craigyjp/Pico-RP2040-Autotune-AS3340/schematics/programmer.pdf

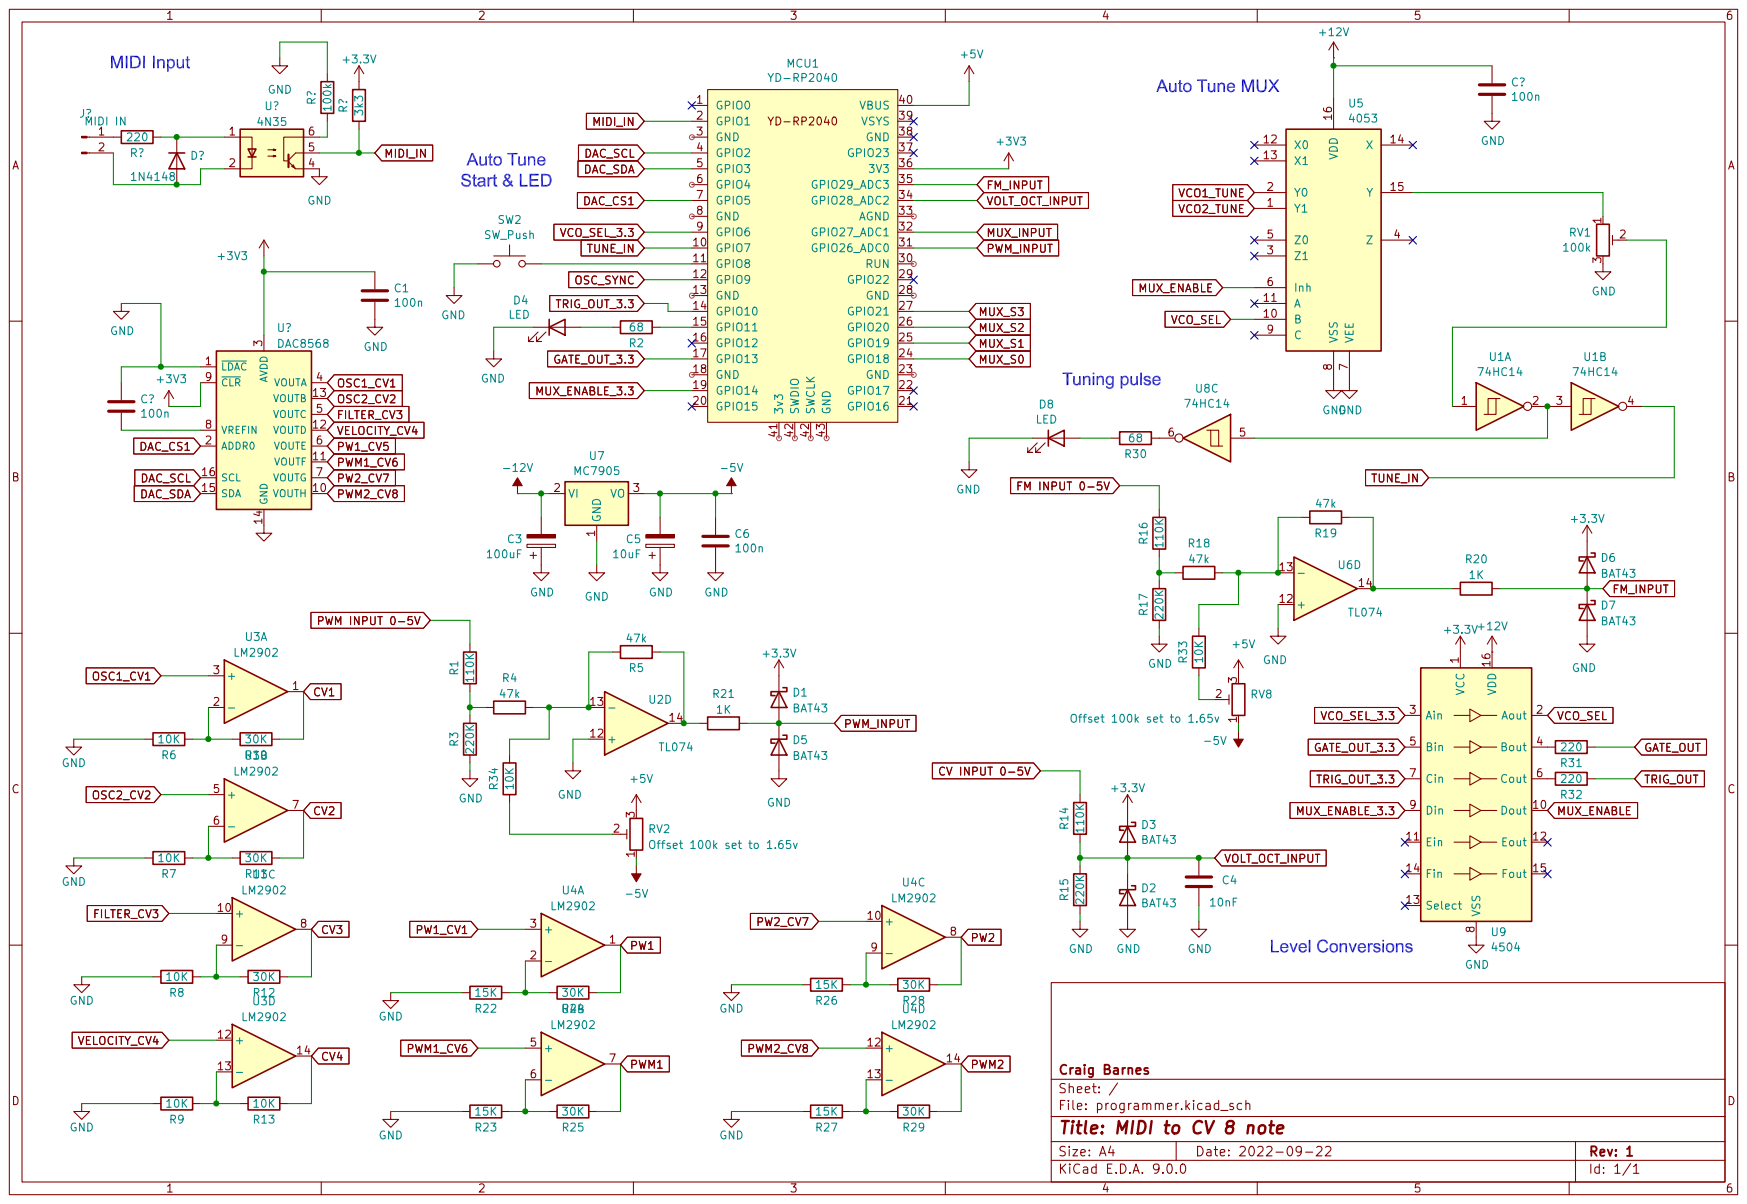
[picture p1: page 1]
