craigyjp/Pico-RP2040-Autotune-AS3340/schematics/mux.pdf

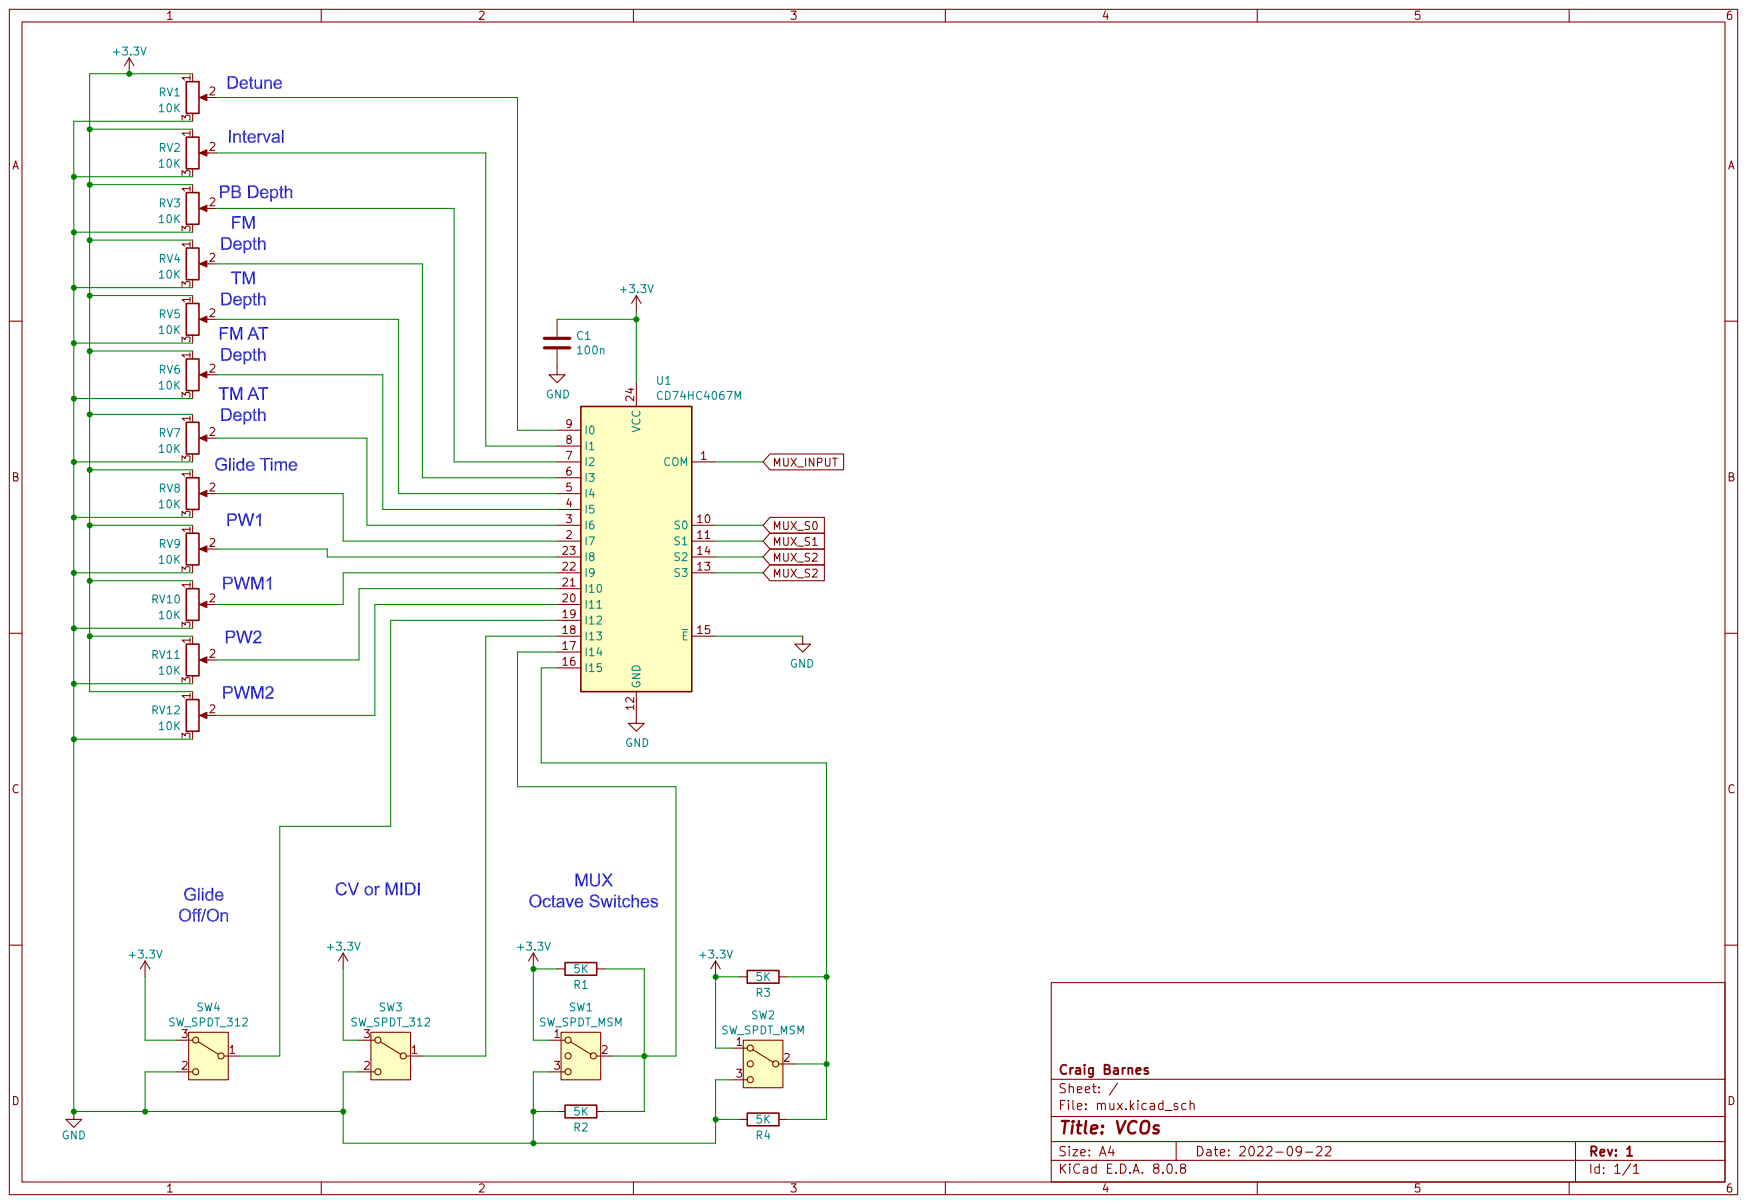
[picture p2: page 1]
