craigyjp/Pico-RP2040-Autotune-AS3340/schematics/Oscillators.pdf

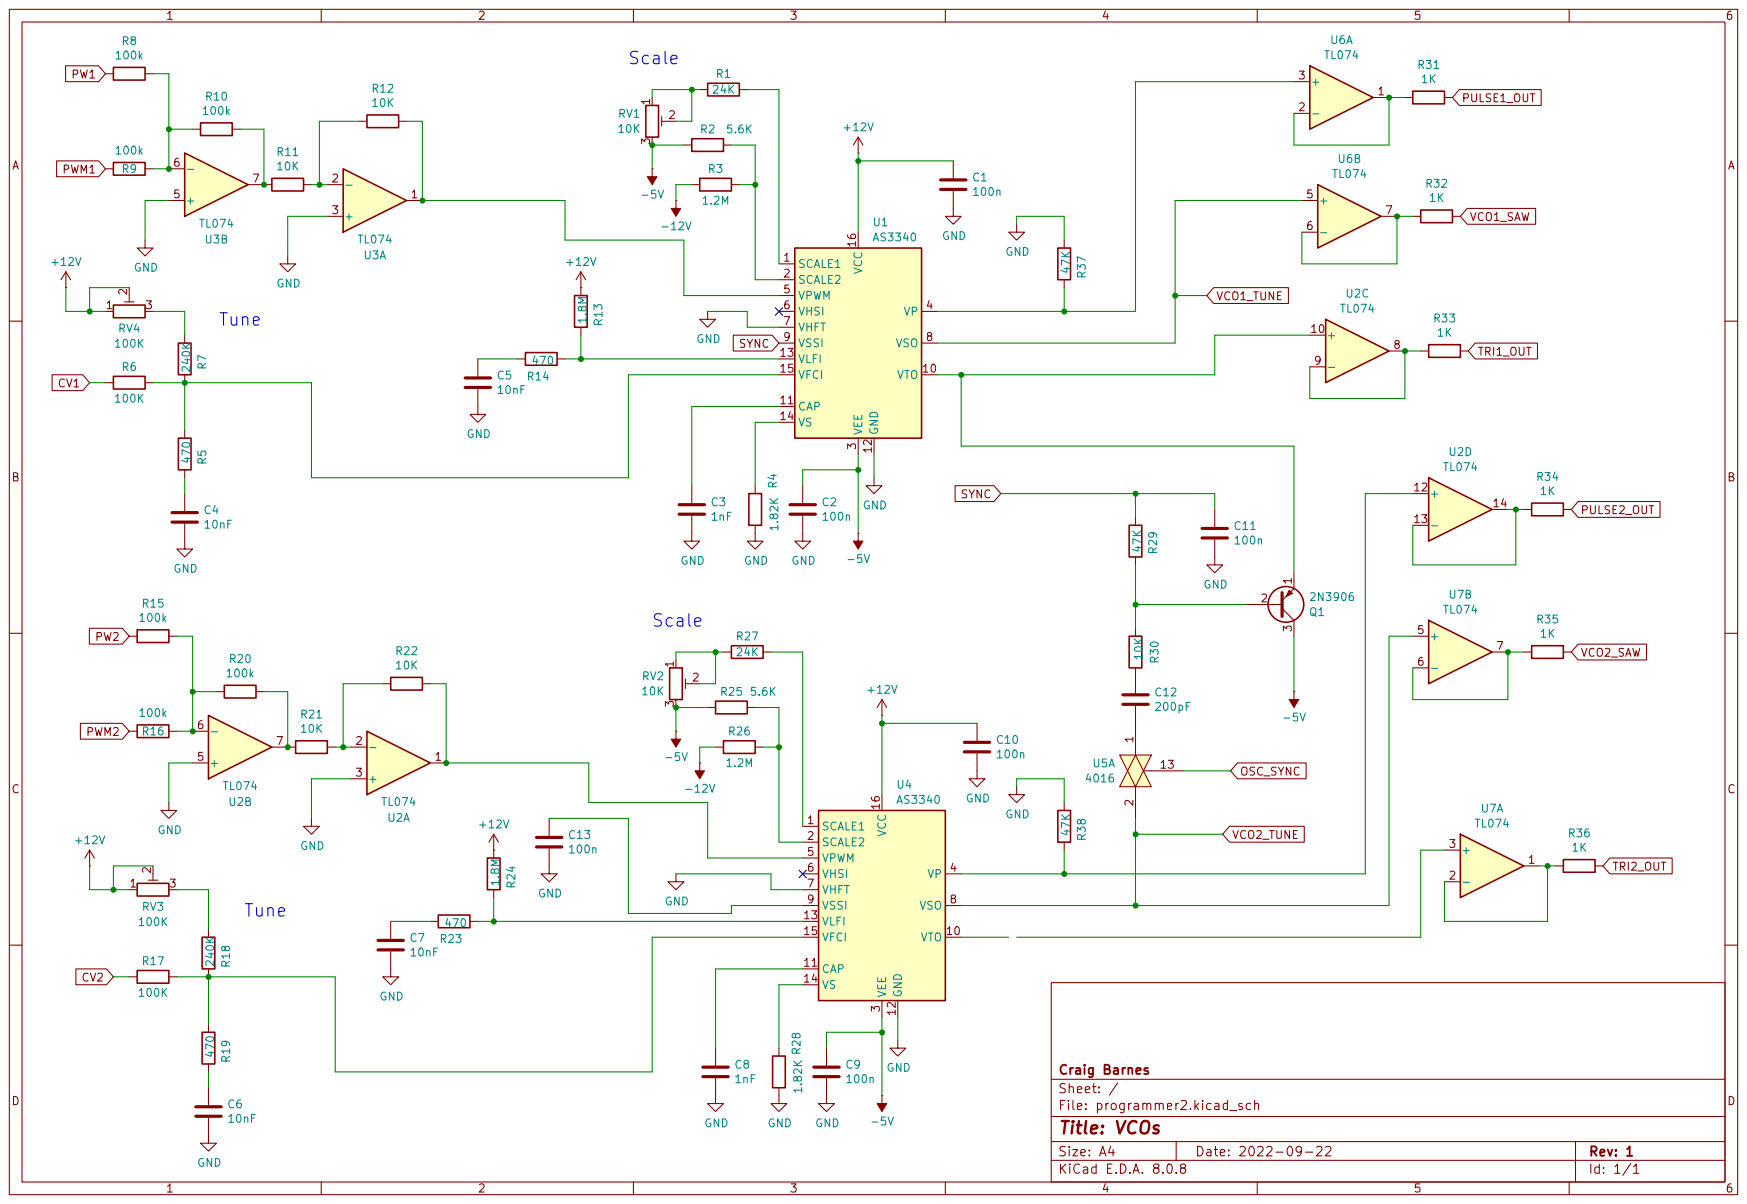
[picture p3: page 1]
