craigyjp/Pico-RP2040-Autotune-AS3340/16bit_1_note_Pico_MIDI_CV_poly_autotune.ino

/*
       MIDI to CV with Autotune

       For RP2040

       Filesystem 1.5Mb/0.5Mb

      Version 1.1

      Copyright (C) 2020 Craig Barnes

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
      This program is distributed in the hope that it will be useful,
      but WITHOUT ANY WARRANTY; without even the implied warranty of
      MERCHANTABILITY or FITNESS FOR A PARTICULAR PURPOSE.  See the
      GNU General Public License <http://www.gnu.org/licenses/> for more details.
*/
#include <Arduino.h>
#include <iostream>
#include <cfloat>  // Include for DBL_MAX
#include <SPI.h>
#include <MIDI.h>
#include "Parameters.h"
#include "Hardware.h"
#include <Adafruit_NeoPixel.h>
#include <FS.h>
#include <LittleFS.h>

struct VoiceAndNote {
  int note;
  int velocity;
  long timeOn;
  bool sustained;  // Sustain flag
  bool keyDown;
  double noteFreq;  // Note frequency
  int position;
  bool noteOn;
};

// Struct to store note data with derivatives
struct NoteData {
  int value;
  double derivative;
};

struct VoiceAndNote voices[NO_OF_VOICES] = {
  { -1, -1, 0, false, false, 0, -1, false },
};

boolean voiceOn[NO_OF_VOICES] = { false };
bool notes[128] = { 0 }, initial_loop = 1;
int8_t noteOrder[40] = { 0 }, orderIndx = { 0 };
bool S1, S2;

// MIDI setup

MIDI_CREATE_INSTANCE(HardwareSerial, Serial1, MIDI);
const int channel = 1;

#define LED_PIN 23    // Define the pin for the built-in RGB LED
#define NUM_PIXELS 1  // Number of WS2812 LEDs

Adafruit_NeoPixel pixels(NUM_PIXELS, LED_PIN, NEO_GRB + NEO_KHZ800);

void setup() {
  Serial.begin(115200);

  // while (!Serial)
  //   ;  // Wait for Serial to connect

  if (!LittleFS.begin()) {
    Serial.println("Failed to mount LittleFS");
    return;
  }

  Serial.println("LittleFS mounted successfully");

  pinMode(AUTO_INPUT, INPUT_PULLUP);

  SPI.setSCK(2);
  SPI.setRX(4);
  SPI.setTX(3);
  SPI.begin();

  delay(10);

  setupHardware();

  //MIDI 5 Pin DIN
  MIDI.begin(masterChan);
  MIDI.setHandleNoteOn(myNoteOn);
  MIDI.setHandleNoteOff(myNoteOff);
  MIDI.setHandlePitchBend(myPitchBend);
  MIDI.setHandleControlChange(myControlChange);
  MIDI.setHandleAfterTouchChannel(myAfterTouch);
  Serial.println("MIDI In DIN Listening");

  pixels.begin();
  delay(500);
  pixels.setPixelColor(0, pixels.Color(0, 255, 0));  // GREEN
  pixels.show();

  loadTuningCorrectionsFromSD();
}

void muxRead() {
  mux1Read = analogRead(MUX_INPUT);

  if (mux1Read > (mux1ValuesPrev[muxInput] + QUANTISE_FACTOR) || mux1Read < (mux1ValuesPrev[muxInput] - QUANTISE_FACTOR)) {
    mux1ValuesPrev[muxInput] = mux1Read;
    switch (muxInput) {

      case MUX1_DETUNE:  // 0
        value = mux1Read;
        DETUNE = map(value, 0, 4095, 0, 127);
        break;

      case MUX1_INTERVAL:  // 1
        value = mux1Read;
        INTERVAL_POT = map(value, 0, 4095, 0, 12);
        break;

      case MUX1_PB_DEPTH:  // 2
        value = mux1Read;
        BEND_WHEEL = map(value, 0, 4095, 0, 12);
        break;

      case MUX1_FM_MOD_DEPTH:  // Modwheel depth to FM 3
        value = mux1Read;
        FM_MOD_WHEEL = map(value, 0, 4095, 0, 16.12);
        break;

      case MUX1_TM_MOD_DEPTH:  // Modwheel Depth to TM 4
        value = mux1Read;
        TM_MOD_WHEEL = map(value, 0, 4095, 0, 16.12);
        break;

      case MUX1_FM_AT_DEPTH:  // AT depth to FM 5
        value = mux1Read;
        FM_AT_WHEEL = map(value, 0, 4095, 0, 16.12);
        break;

      case MUX1_TM_AT_DEPTH:  // AT depth to TM 6
        value = mux1Read;
        TM_AT_WHEEL = map(value, 0, 4095, 0, 16.12);
        break;

      case MUX1_GLIDE_TIME:  // 7
        GLIDE_TIME = mux1Read;
        portamentoTime = map(GLIDE_TIME, 0, 4095, 0, 10000);
        break;

      case MUX1_PW1:  // 8
        value = mux1Read;
        PW1 = map(value, 0, 4095, 0, 17000);
        break;

      case MUX1_PWM1_DEPTH:  // 9
        value = mux1Read;
        PWM1 = map(value, 0, 4095, 0, 20000);
        break;

      case MUX1_PW2:  // 10
        value = mux1Read;
        PW2 = map(value, 0, 4095, 0, 17000);
        break;

      case MUX1_PWM2_DEPTH:  // 11
        value = mux1Read;
        PWM2 = map(value, 0, 4095, 0, 20000);
        break;

      case MUX1_GLIDE_ON_OFF:  // 12
        value = mux1Read;
        portamentoOn = map(value, 0, 4095, 0, 1);
        break;

      case MUX1_CV_MIDI:  // 13
        value = mux1Read;
        value = map(value, 0, 127, 0, 1);
        switch (value) {
          case 0:
            cvMidi = false;
            break;
          case 1:
            cvMidi = true;
            break;
        }
        break;

      case MUX1_OCTAVE_A:  // 14
        value = mux1Read;
        value = map(value, 0, 127, 0, 2);
        switch (value) {
          case 0:
            OCTAVE_A = -12;
            break;
          case 1:
            OCTAVE_A = 0;
            break;
          case 2:
            OCTAVE_A = 12;
            break;
        }
        break;

      case MUX1_OCTAVE_B:  // 15
        value = mux1Read;
        value = map(value, 0, 127, 0, 2);
        switch (value) {
          case 0:
            OCTAVE_B = -12;
            break;
          case 1:
            OCTAVE_B = 0;
            break;
          case 2:
            OCTAVE_B = 12;
            break;
        }
        break;
    }
  }

  muxInput++;
  if (muxInput >= MUXCHANNELS)
    muxInput = 0;

  digitalWrite(MUX_S0, muxInput & 0b0001);
  digitalWrite(MUX_S1, muxInput & 0b0010);
  digitalWrite(MUX_S2, muxInput & 0b0100);
  digitalWrite(MUX_S3, muxInput & 0b1000);
}

void readNoteCV() {
  if (cvMidi) {
    // Step 1: Read ADC and apply calibration
    adcBuffer[bufferIndex] = analogRead(VOLT_OCT_INPUT) * AD_CH1_calb;
    bufferIndex = (bufferIndex + 1) % NUM_SAMPLES;

    // Compute moving average
    int adcSum = 0;
    for (int i = 0; i < NUM_SAMPLES; i++) {
      adcSum += adcBuffer[i];
    }
    int adcValue = (adcSum / NUM_SAMPLES) - ADC_OFFSET;  // Offset correction

    // Prevent negative values
    if (adcValue < 0) {
      adcValue = 0;
    }

    // Step 3: Ignore small changes
    if (abs(old_ADC - adcValue) > HYSTERESIS_THRESHOLD) {

      // Step 4: Quantize input
      for (int i = 0; i <= 60; i++) {

        if (adcValue >= cv_qnt_thr_buf1[i] && adcValue < cv_qnt_thr_buf1[i + 1]) {
          search_qnt = i;
          cmp1 = adcValue - cv_qnt_thr_buf1[i];
          cmp2 = cv_qnt_thr_buf1[i + 1] - adcValue;
          break;
        }
      }

      // Failsafe: If no match is found, force a default note
      if (search_qnt == -1) {
        Serial.println("⚠️ No quantized match found! Using default fallback.");
        search_qnt = 0;
      }

      int quantizedValue = (cmp1 >= cmp2) ? cv_qnt_thr_buf1[search_qnt + 1] : cv_qnt_thr_buf1[search_qnt];
      quantizedValue = constrain(quantizedValue, 0, 4095);

      // Convert to MIDI note
      int midiNote = round(quantizedValue / 68.0);

      // Step 6: Send MIDI if note has changed
      if (midiNote != previousMidiNote) {
        if (previousMidiNote >= 0) {
          myNoteOff(masterChan, previousMidiNote, 127);
        }
        myNoteOn(masterChan, midiNote + 36, 127);
        previousMidiNote = midiNote + 36;
      }

      old_ADC = adcValue;
    }
  }
}

void saveTuningCorrectionsToSD() {
  // Remove the file if it exists
  if (LittleFS.exists("tuning.txt")) {
    LittleFS.remove("tuning.txt");
  }

  // Open the file for writing
  File file = LittleFS.open("tuning.txt", "w");
  if (file) {
    for (int o = 0; o < (numOscillators + 1); o++) {
      for (int i = 0; i < 128; i++) {
        file.print(i);                       // Note
        file.print(",");                     // Delimiter
        file.print(o);                       // Oscillator
        file.print(",");                     // Delimiter
        file.println(autotune_value[i][o]);  // Value
      }
    }
    file.close();
    Serial.println("Autotune values saved to LittleFS.");
  } else {
    Serial.println("Error opening file for writing.");
  }
}

void loadTuningCorrectionsFromSD() {
  // Open the file for reading
  File file = LittleFS.open("tuning.txt", "r");
  if (file) {
    while (file.available()) {
      // Read a line from the file
      String line = file.readStringUntil('\n');

      // Parse the line
      int firstComma = line.indexOf(',');       // First delimiter
      int secondComma = line.lastIndexOf(',');  // Second delimiter

      // Extract note, oscillator, and value
      if (firstComma != -1 && secondComma != -1 && secondComma > firstComma) {
        int note = line.substring(0, firstComma).toInt();
        int osc = line.substring(firstComma + 1, secondComma).toInt();
        int value = line.substring(secondComma + 1).toInt();

        // Validate indices and populate the array
        if (note >= 0 && note < 128 && osc >= 0 && osc <= numOscillators) {
          autotune_value[note][osc] = value;
        } else {
          Serial.println("Invalid data in tuning.txt");
        }
      }
    }
    file.close();
    Serial.println("Tuning corrections loaded from LittleFS.");
  } else {
    Serial.println("Failed to open tuning.txt on LittleFS.");
  }
}

void startAutotune() {
  pixels.setPixelColor(0, pixels.Color(255, 0, 0));  // RED
  pixels.show();
  digitalWrite(TUNE_LED, HIGH);
  allNotesOff();
  autotuneStart = true;
  oscillator = 0;
  tuneNote = 0;
  setVCOStolowestA();
  delay(200);
  workingNote = A_NOTES[tuneNote];
  targetFrequency = midi_to_freqs[workingNote][1];
  digitalWrite(VCO_SEL, LOW);
  digitalWrite(MUX_ENABLE, LOW);
  delayMicroseconds(200);
}

void autotune() {
  int midiNote = A_NOTES[tuneNote];
  double targetFrequency = midi_to_freqs[midiNote][1];
  Serial.print("MIDI Note: ");
  Serial.println(midiNote);
  Serial.print("Target Frequency: ");
  Serial.println(targetFrequency);

  setOscillator(midiNote, oscillator);
  delay(10);  // Allow stabilization after setting the oscillator

  float initialFreq = directCount(targetFrequency);
  //double initialFreq = directCountAverage(3);  // Average initial measurement
  Serial.print("Initial Frequency: ");
  Serial.println(initialFreq);

  int minError = -255;
  int maxError = 255;
  int bestError = 0;
  double bestFreqDiff = DBL_MAX;

  while (minError <= maxError) {
    int midError = (minError + maxError) / 2;
    updateOscillator(midiNote, midError, oscillator);
    delay(10);  // Allow oscillator to stabilize

    // Take multiple frequency measurements and average them
    double measuredFreq = directCount(targetFrequency);
    double freqDiff = abs(measuredFreq - targetFrequency);

    Serial.print("Measured Frequency: ");
    Serial.print(measuredFreq);
    Serial.print(" | Frequency Difference: ");
    Serial.println(freqDiff);

    if (freqDiff < bestFreqDiff) {
      bestFreqDiff = freqDiff;
      bestError = midError;
    }

    // Adjust the binary search range
    if (measuredFreq < targetFrequency) {
      minError = midError + 1;  // Increase offset
    } else if (measuredFreq > targetFrequency) {
      maxError = midError - 1;  // Decrease offset
    } else {
      bestError = midError;  // Exact match found
      break;
    }
  }

  // Save the best error value
  autotune_value[midiNote][oscillator] = bestError;
  Serial.print("Oscillator: ");
  Serial.print(oscillator);
  Serial.print(" | Note: ");
  Serial.print(midiNote);
  Serial.print(" | Best Tune Offset: ");
  Serial.println(bestError);

  // Move to the next note/oscillator
  tuneNote++;
  if (tuneNote >= A_NOTES_COUNT) {
    tuneNote = 0;
    oscillator++;
    pixels.setPixelColor(0, pixels.Color(0, 0, 255));  // BLUE
    pixels.show();
    Serial.print("Oscillator: ");
    Serial.println(oscillator);
    if (oscillator > numOscillators) {
      autotuneStart = false;  // Autotune completed
      extrapolateNotes();
      Serial.println("Auto Tune Finished");
      pixels.setPixelColor(0, pixels.Color(0, 255, 0));  // GREEN
      pixels.show();
      digitalWrite(TUNE_LED, LOW);
      digitalWrite(MUX_ENABLE, HIGH);
    } else {
      // Switch to the next oscillator
      selectMuxInput();
      delay(10);  // Stabilize MUX switching
    }
  }
}

void setOscillator(int midiNote, int oscillator) {
  switch (oscillator) {
    case 0:
      setDAC(DAC_NOTE1, (midiNote - 36), 0, 0);
      break;
    case 1:
      setDAC(DAC_NOTE1, (midiNote - 36), 0, 1);
      break;
  }
}

void updateOscillator(int note, int error, int oscillator) {
  switch (oscillator) {
    case 0:
      setDAC(DAC_NOTE1, (note - 36), error, 0);
      break;
    case 1:
      setDAC(DAC_NOTE1, (note - 36), error, 1);
      break;
  }
}

void setDAC(int chipSelect, int note, int error, int oscillator) {
  switch (oscillator) {
    case 0:
      mV = (unsigned int)(((float)(note)*NOTE_SF + 0.5) + (VOLTOFFSET + error));
      sample_data = (channel_a & 0xFFF0000F) | (((mV)&0xFFFF) << 4);
      outputDAC(chipSelect, sample_data);
      break;
    case 1:
      mV = (unsigned int)(((float)(note)*NOTE_SF + 0.5) + (VOLTOFFSET + error));
      sample_data = (channel_b & 0xFFF0000F) | (((mV)&0xFFFF) << 4);
      outputDAC(chipSelect, sample_data);
      break;
  }
}

//////////////////////////////////////////////////////////////////////////////

void extrapolateNotes() {
  for (int o = 0; o <= numOscillators; o++) {
    // Extrapolate and interpolate across the full MIDI note range (0-127)
    for (int i = 0; i < 128; i++) {
      // Find the nearest lower and higher known notes in A_NOTES
      int lowerNote = -1;
      int higherNote = -1;

      for (int j = 0; j < A_NOTES_COUNT; j++) {
        if (A_NOTES[j] <= i) {
          lowerNote = A_NOTES[j];
        }
        if (A_NOTES[j] > i) {
          higherNote = A_NOTES[j];
          break;
        }
      }

      if (lowerNote != -1 && higherNote != -1) {
        // Interpolation between lowerNote and higherNote
        int lowerValue = autotune_value[lowerNote][o];
        int higherValue = autotune_value[higherNote][o];
        double t = static_cast<double>(i - lowerNote) / (higherNote - lowerNote);
        autotune_value[i][o] = constrain(
          static_cast<int>(lowerValue + t * (higherValue - lowerValue)),
          -32768, 32767);
      } else if (lowerNote != -1) {
        // Extrapolation below the first known note
        int lowerValue = autotune_value[lowerNote][o];
        autotune_value[i][o] = constrain(lowerValue, -32768, 32767);
      } else if (higherNote != -1) {
        // Extrapolation above the last known note
        int higherValue = autotune_value[higherNote][o];
        autotune_value[i][o] = constrain(higherValue, -32768, 32767);
      }
    }
  }

  saveTuningCorrectionsToSD();
}

//////////////////////////////////////////////////////////////////////

void loadSDCardNow() {
  loadTuningCorrectionsFromSD();
}

void debugFrequencyReading() {
  float frequency = directCount(targetFrequency);  // Measure frequency
  Serial.print("Frequency: ");
  Serial.print(frequency, 1);  // Print frequency with 0.1 Hz resolution
  Serial.println(" Hz");
}

void my_isr() {
  count++;  // Increment count on each rising edge
}

float directCount(float targetFreq) {
  count = 0;  // Reset count

  // Dynamically calculate measurement time in microseconds
  uint32_t measurementDuration;
  if (targetFreq <= 50.0) {
    measurementDuration = 2E6;  // 2 seconds for low frequencies (<= 50 Hz)
  } else if (targetFreq <= 100.0) {
    measurementDuration = 1E6;  // 1 second for moderate frequencies
  } else {
    measurementDuration = 5E5;  // 500 ms for higher frequencies
  }

  uint32_t startTime = micros();
  uint32_t targetTime = startTime + measurementDuration;

  // Enable interrupt for rising edge detection
  attachInterrupt(digitalPinToInterrupt(AUTO_INPUT), my_isr, RISING);

  // Wait for the measurement duration
  while (micros() - startTime < measurementDuration) {}

  // Disable interrupt to stop counting
  detachInterrupt(digitalPinToInterrupt(AUTO_INPUT));

  // Calculate frequency based on the measurement time
  float frequency = static_cast<float>(count) * (1E6 / measurementDuration);
  return frequency;
}

void loop() {

  if (autotuneStart) {
    autotune();
  } else {
    updateTimers();
    MIDI.read(masterChan);  //MIDI 5 Pin DIN
    readNoteCV();
    mod_task();
    pwm_task();
    adjustInterval();
    updateVoice1();
    muxRead();

    int sensorVal = digitalRead(AUTO_BUTTON);
    if (!sensorVal) {
      startAutotune();
    }
  }
}

void setVCOStolowestA() {
  mV = (unsigned int)(((float)(33) * NOTE_SF + 0.5) + (VOLTOFFSET + autotune_value[33][0]));
  sample_data1 = (channel_a & 0xFFF0000F) | (((int(mV)) & 0xFFFF) << 4);
  outputDAC(DAC_NOTE1, sample_data1);
  mV = (unsigned int)(((float)(33) * NOTE_SF + 0.5) + (VOLTOFFSET + autotune_value[33][1]));
  sample_data1 = (channel_b & 0xFFF0000F) | (((int(mV)) & 0xFFFF) << 4);
  outputDAC(DAC_NOTE1, sample_data1);
}

void ResetAutoTuneValues() {
  for (int o = 0; o < (numOscillators + 1); o++) {
    for (int i = 0; i < 128; i++) {
      (autotune_value[i][o]) = 0;
    }
  }
  Serial.print("All Autotune Values are 0");
  Serial.println();
  Serial.print("Writing all 0 to SD card");
  Serial.println();
  saveTuningCorrectionsToSD();
}

void DisplayAutoTuneValues() {

  Serial.println("=== Autotune Values ===");
  if (displayvalues) {
    for (int o = 0; o < (numOscillators + 1); o++) {
      Serial.print("Oscillator ");
      Serial.print(o);
      Serial.println(":");
      for (int i = 0; i < 128; i++) {
        Serial.print("  Note ");
        Serial.print(i);
        Serial.print(" ");
        Serial.println(autotune_value[i][o]);
      }
    }
  }
}

void allowOsc1Through() {

  if (osc1Through) {
    digitalWrite(VCO_SEL, LOW);
    delayMicroseconds(100);
    digitalWrite(MUX_ENABLE, LOW);
  } else {
    digitalWrite(VCO_SEL, LOW);
    digitalWrite(MUX_ENABLE, HIGH);
  }
}

void myPitchBend(byte channel, int bend) {
  if ((channel == masterChan) || (masterChan == 0)) {
    switch (BEND_WHEEL) {
      case 12:
        bend_data = map(bend, -8192, 8191, -3235, 3235);
        break;

      case 11:
        bend_data = map(bend, -8192, 8191, -2970, 2969);
        break;

      case 10:
        bend_data = map(bend, -8192, 8191, -2700, 2699);
        break;

      case 9:
        bend_data = map(bend, -8192, 8191, -2430, 2429);
        break;

      case 8:
        bend_data = map(bend, -8192, 8191, -2160, 2159);
        break;

      case 7:
        bend_data = map(bend, -8192, 8191, -1890, 1889);
        break;

      case 6:
        bend_data = map(bend, -8192, 8191, -1620, 1619);
        break;

      case 5:
        bend_data = map(bend, -8192, 8191, -1350, 1349);
        break;

      case 4:
        bend_data = map(bend, -8192, 8191, -1080, 1079);
        break;

      case 3:
        bend_data = map(bend, -8192, 8191, -810, 809);
        break;

      case 2:
        bend_data = map(bend, -8192, 8191, -540, 539);
        break;

      case 1:
        bend_data = map(bend, -8192, 8191, -270, 270);
        break;

      case 0:
        bend_data = 0;
        break;
    }
    // sample_data = (channel_a & 0xFFF0000F) | (((int(bend * 0.395) + 13180) & 0xFFFF) << 4);
    // outputDAC(DAC_NOTE5, sample_data);
  }
}

void adjustInterval() {
  if (INTERVAL_POT != INTERVAL) {
    Serial.print("Interval setting ");
    Serial.println(INTERVAL_POT);
  }
  switch (INTERVAL_POT) {
    case 12:
      INTERVAL = 12;
      break;

    case 11:
      INTERVAL = 11;
      break;

    case 10:
      INTERVAL = 10;
      break;

    case 9:
      INTERVAL = 9;
      break;

    case 8:
      INTERVAL = 8;
      break;

    case 7:
      INTERVAL = 7;
      break;

    case 6:
      INTERVAL = 6;
      break;

    case 5:
      INTERVAL = 5;
      break;

    case 4:
      INTERVAL = 4;
      break;

    case 3:
      INTERVAL = 3;
      break;

    case 2:
      INTERVAL = 2;
      break;

    case 1:
      INTERVAL = 1;
      break;

    case 0:
      INTERVAL = 0;
      break;
  }
}

// Reads MIDI CC messages
void myControlChange(byte channel, byte number, byte value) {
  if ((channel == masterChan) || (masterChan == 0)) {
    switch (number) {

      case 1:
        FM_RANGE_UPPER = int(value * FM_MOD_WHEEL);
        FM_RANGE_LOWER = (FM_RANGE_UPPER - FM_RANGE_UPPER - FM_RANGE_UPPER);
        TM_RANGE_UPPER = int(value * TM_MOD_WHEEL);
        TM_RANGE_LOWER = (TM_RANGE_UPPER - TM_RANGE_UPPER - TM_RANGE_UPPER);
        break;

      case 5:                                           // Portamento time
        portamentoTime = map(value, 0, 127, 0, 10000);  // Map to a max of 2 seconds
        Serial.print("Portamento Time: ");
        Serial.println(portamentoTime);
        break;

      case 14:
        INTERVAL_POT = map(value, 0, 127, 0, 12);
        break;

      case 15:
        DETUNE = value;
        break;

      case 16:
        BEND_WHEEL = map(value, 0, 127, 0, 12);
        break;

      case 17:
        FM_MOD_WHEEL = map(value, 0, 127, 0, 16.2);
        break;

      case 18:
        TM_MOD_WHEEL = map(value, 0, 127, 0, 16.2);
        break;

      case 19:
        FM_AT_WHEEL = map(value, 0, 127, 0, 16.2);
        break;

      case 20:
        TM_AT_WHEEL = map(value, 0, 127, 0, 16.2);
        break;

      case 21:
        value = map(value, 0, 127, 0, 2);
        switch (value) {
          case 0:
            OCTAVE_A = -12;
            break;
          case 1:
            OCTAVE_A = 0;
            break;
          case 2:
            OCTAVE_A = 12;
            break;
        }
        break;

      case 22:
        value = map(value, 0, 127, 0, 2);
        switch (value) {
          case 0:
            OCTAVE_B = -12;
            break;
          case 1:
            OCTAVE_B = 0;
            break;
          case 2:
            OCTAVE_B = 12;
            break;
        }
        break;

      case 23:
        PW1 = map(value, 0, 127, 0, 17000);
        break;

      case 24:
        PWM1 = map(value, 0, 127, 0, 20000);
        break;

      case 25:
        PW2 = map(value, 0, 127, 0, 17000);
        break;

      case 26:
        PWM2 = map(value, 0, 127, 0, 20000);
        break;

      case 65:  // Portamento on/off
        switch (value) {
          case 127:
            portamentoOn = true;
            Serial.print("Portamento On: ");
            Serial.println(portamentoOn);
            break;
          case 0:
            portamentoOn = false;
            Serial.print("Portamento Off: ");
            Serial.println(portamentoOn);
            break;
        }
        break;

      case 121:
        switch (value) {
          case 127:
            startAutotune();
            break;
        }
        break;

      case 122:
        switch (value) {
          case 127:
            ResetAutoTuneValues();
            break;
        }
        break;

      case 123:
        switch (value) {
          case 127:
            allNotesOff();
            break;
        }
        break;

      case 127:
        keyboardMode = map(value, 0, 127, 0, 2);
        if (keyboardMode > 0 && keyboardMode < 3) {
          allNotesOff();
        }
        break;
    }
  }
}

void myAfterTouch(byte channel, byte value) {
  if ((channel == masterChan) || (masterChan == 0)) {
    FM_AT_RANGE_UPPER = int(value * FM_AT_WHEEL);
    FM_AT_RANGE_LOWER = (FM_AT_RANGE_UPPER - FM_AT_RANGE_UPPER - FM_AT_RANGE_UPPER);
    TM_AT_RANGE_UPPER = int(value * TM_AT_WHEEL);
    TM_AT_RANGE_LOWER = (TM_AT_RANGE_UPPER - TM_AT_RANGE_UPPER - TM_AT_RANGE_UPPER);
  }
}

// Get the LFO input on the FM_INPUT
void mod_task() {

  MOD_VALUE = analogRead(FM_INPUT);
  FM_VALUE = map(MOD_VALUE, 0, 4095, FM_RANGE_LOWER, FM_RANGE_UPPER);
  FM_AT_VALUE = map(MOD_VALUE, 0, 4095, FM_AT_RANGE_LOWER, FM_AT_RANGE_UPPER);
  TM_VALUE = map(MOD_VALUE, 0, 4095, TM_RANGE_LOWER, TM_RANGE_UPPER);
  TM_AT_VALUE = map(MOD_VALUE, 0, 4095, TM_AT_RANGE_LOWER, TM_AT_RANGE_UPPER);
}

// Get the LFO input on the FM_INPUT
void pwm_task() {

  PWM_VALUE = analogRead(PWM_INPUT);
  PWM1_VALUE = map(PWM_VALUE, 0, 4095, 0, PWM1);
  PWM2_VALUE = map(PWM_VALUE, 0, 4095, 0, PWM2);
}

void commandTopNote() {
  int topNote = 0;
  bool noteActive = false;

  for (int i = 0; i < 128; i++) {
    if (notes[i]) {
      topNote = i;
      noteActive = true;
    }
  }

  if (noteActive) {
    commandNote(topNote);
  } else {  // All notes are off, turn off gate
    digitalWrite(GATE_NOTE1, LOW);
  }
}

void commandBottomNote() {
  int bottomNote = 0;
  bool noteActive = false;

  for (int i = 87; i >= 0; i--) {
    if (notes[i]) {
      bottomNote = i;
      noteActive = true;
    }
  }

  if (noteActive) {
    commandNote(bottomNote);
  } else {  // All notes are off, turn off gate
    digitalWrite(GATE_NOTE1, LOW);
  }
}

void commandLastNote() {

  int8_t noteIndx;

  for (int i = 0; i < 40; i++) {
    noteIndx = noteOrder[mod(orderIndx - i, 40)];
    if (notes[noteIndx]) {
      commandNote(noteIndx);
      return;
    }
  }
  digitalWrite(GATE_NOTE1, LOW);  // All notes are off
}

void commandNote(int noteMsg) {
  note1 = noteMsg;
  digitalWrite(GATE_NOTE1, HIGH);
  digitalWrite(TRIG_NOTE1, HIGH);
  noteTrig[0] = millis();
}

// MIDI note on callback
void myNoteOn(byte channel, byte note, byte velocity) {

  //Check for out of range notes
  if (note < 0 || note > 127) return;

  // Calculate new target mV values including all real-time corrections
  //oscanote1 = note + OCTAVE_A;
  targetMV_a = (unsigned int)(((float)(note + transpose + realoctave) * NOTE_SF + 0.5) + (autotune_value[note][0]));

  //oscbnote1 = note + INTERVAL + OCTAVE_B;
  targetMV_b = (unsigned int)(((float)(note + transpose + realoctave) * NOTE_SF + 0.5) + (autotune_value[note][1]));

  if (portamentoOn) {
    // If portamento is enabled, start glide from the **current** value
    initialMV_a = currentMV_a;
    initialMV_b = currentMV_b;
    glideStartTime = millis();  // Start the glide transition
    portamentoActive = true;
  } else {
    // If portamento is OFF, instantly set frequency
    currentMV_a = targetMV_a;
    currentMV_b = targetMV_b;
    portamentoActive = false;
  }

  switch (keyboardMode) {

    case 0:
    case 1:
    case 2:
      if (keyboardMode == 0) {
        S1 = 1;
        S2 = 1;
      }
      if (keyboardMode == 1) {
        S1 = 0;
        S2 = 1;
      }
      if (keyboardMode == 2) {
        S1 = 0;
        S2 = 0;
      }
      noteMsg = note;

      if (velocity == 0) {
        notes[noteMsg] = false;
      } else {
        notes[noteMsg] = true;
      }
      voices[0].velocity = velocity;

      if (S1 && S2) {  // Highest note priority
        commandTopNote();
      } else if (!S1 && S2) {  // Lowest note priority
        commandBottomNote();
      } else {                 // Last note priority
        if (notes[noteMsg]) {  // If note is on and using last note priority, add to ordered list
          orderIndx = (orderIndx + 1) % 40;
          noteOrder[orderIndx] = noteMsg;
        }
        commandLastNote();
      }
      break;
  }
}

// MIDI Note Off callback
void myNoteOff(byte channel, byte note, byte velocity) {

  // if (portamentoActive) {
  //   // Immediately finish the glide on note-off
  //   currentMV_a = targetMV_a;
  //   currentMV_b = targetMV_b;
  //   portamentoActive = false;  // Stop the glide
  // }

  switch (keyboardMode) {
    case 0:
    case 1:
    case 2:
      if (keyboardMode == 0) {
        S1 = 1;
        S2 = 1;
      }
      if (keyboardMode == 1) {
        S1 = 0;
        S2 = 1;
      }
      if (keyboardMode == 2) {
        S1 = 0;
        S2 = 0;
      }
      noteMsg = note;

      notes[noteMsg] = false;

      if (S1 && S2) {  // Highest note priority
        commandTopNote();
      } else if (!S1 && S2) {  // Lowest note priority
        commandBottomNote();
      } else {                 // Last note priority
        if (notes[noteMsg]) {  // If note is on and using last note priority, add to ordered list
          orderIndx = (orderIndx + 1) % 40;
          noteOrder[orderIndx] = noteMsg;
        }
        commandLastNote();
      }
      break;
  }
}

// Kills the trigger after 20 mS
void updateTimers() {

  if (millis() > noteTrig[0] + trigTimeout) {
    digitalWrite(TRIG_NOTE1, LOW);  // Set trigger low after 20 msec
  }
}

// Updates the DAC with the note1 data and adds in all offsets, bend, modulation, aftertouch, octave range
void updateVoice1() {
  static unsigned long lastUpdateTime = 0;  // Tracks the last time this function was called
  unsigned long currentTime = millis();     // Get the current time in milliseconds
  unsigned long deltaTime = currentTime - lastUpdateTime;

  if (portamentoActive) {
    // Calculate the progress as a fraction of portamentoTime
    float progress = (float)(millis() - glideStartTime) / (float)portamentoTime;

    // Clamp progress between 0.0 and 1.0
    if (progress > 1.0) progress = 1.0;

    // Apply an **adjusted** exponential scaling for smooth glide
    float rate = 3.5;  // Tweak this value for a more natural feel
    float exponentialProgress = (1.0 - exp(-rate * progress)) / (1.0 - exp(-rate));

    // Interpolate currentMV values for an **exponential glide**
    currentMV_a = initialMV_a + (targetMV_a - initialMV_a) * exponentialProgress;
    currentMV_b = initialMV_b + (targetMV_b - initialMV_b) * exponentialProgress;

    // If the glide is **complete**, snap to final values and disable glide
    if (progress >= 1.0) {
      currentMV_a = targetMV_a;
      currentMV_b = targetMV_b;
      portamentoActive = false;
    }
  }

  // Now continuously apply parameters to the frequency calculation

  // Calculate mV for channel_a (Oscillator A)
  oscanote1 = note1 + OCTAVE_A;  // Apply the correct octave adjustment for this oscillator
  additionalmV = (unsigned int)(((float)(OCTAVE_A)*NOTE_SF + 0.5) + (VOLTOFFSET + bend_data + FM_VALUE + FM_AT_VALUE));
  finalmV = (currentMV_a + additionalmV);
  sample_data1 = (channel_a & 0xFFF0000F) | (((int(finalmV)) & 0xFFFF) << 4);
  outputDAC(DAC_NOTE1, sample_data1);

  // Calculate mV for channel_b (Oscillator B)
  oscbnote1 = note1 + INTERVAL + OCTAVE_B;  // Apply interval and octave B adjustments
  additionalmV = (unsigned int)(((float)(INTERVAL + OCTAVE_B) * NOTE_SF + 0.5) + (VOLTOFFSET + bend_data + FM_VALUE + FM_AT_VALUE + DETUNE));
  finalmV = (currentMV_b + additionalmV);
  sample_data1 = (channel_b & 0xFFF0000F) | (((int(finalmV)) & 0xFFFF) << 4);
  outputDAC(DAC_NOTE1, sample_data1);

  // Apply TM_VALUE (presumably for a modulating signal)
  mV = (unsigned int)(((float)(note1 + transpose + realoctave) * NOTE_SF + 0.5) + (TM_VALUE));
  sample_data1 = (channel_c & 0xFFF0000F) | (((int(mV)) & 0xFFFF) << 4);
  outputDAC(DAC_NOTE1, sample_data1);

  // Apply velocity (velocity CV output)
  velmV = ((unsigned int)((float)voices[0].velocity) * VEL_SF);
  vel_data1 = (channel_d & 0xFFF0000F) | (((int(velmV)) & 0xFFFF) << 4);
  outputDAC(DAC_NOTE1, vel_data1);

  sample_data1 = (channel_e & 0xFFF0000F) | (((int(PW1)) & 0xFFFF) << 4);
  outputDAC(DAC_NOTE1, sample_data1);

  sample_data1 = (channel_f & 0xFFF0000F) | (((int(PWM1_VALUE)) & 0xFFFF) << 4);
  outputDAC(DAC_NOTE1, sample_data1);

  sample_data1 = (channel_g & 0xFFF0000F) | (((int(PW2)) & 0xFFFF) << 4);
  outputDAC(DAC_NOTE1, sample_data1);

  sample_data1 = (channel_h & 0xFFF0000F) | (((int(PWM2_VALUE)) & 0xFFFF) << 4);
  outputDAC(DAC_NOTE1, sample_data1);

  // Update last update time
  lastUpdateTime = currentTime;
}

// Resets all the notes to off
void allNotesOff() {
  digitalWrite(GATE_NOTE1, LOW);

  voices[0].note = -1;

  voiceOn[0] = false;
}


void outputDAC(int CHIP_SELECT, uint32_t sample_data) {
  SPI.beginTransaction(SPISettings(20000000, MSBFIRST, SPI_MODE1));
  digitalWrite(CHIP_SELECT, LOW);
  delayMicroseconds(1);
  SPI.transfer16(sample_data >> 16);
  SPI.transfer16(sample_data);
  delayMicroseconds(3);  // Settling time delay
  digitalWrite(CHIP_SELECT, HIGH);
  SPI.endTransaction();
}

int mod(int a, int b) {
  int r = a % b;
  return r < 0 ? r + b : r;
}

void selectMuxInput() {
  switch (oscillator) {

    // Board 1 A
    case 0:
      digitalWrite(VCO_SEL, LOW);
      break;

    // Board 1 B
    case 1:
      digitalWrite(VCO_SEL, HIGH);
      break;
  }
}
