craigyjp/Pico-RP2040-Autotune-AS3340/(commit log)

2025-01-26 Added schematics
2025-01-27 Added tuning correction saving to LittleFS
    [16bit_1_note_Pico_MIDI_CV_poly_autotune.ino, Hardware.h]
2025-01-28 Updated for 1v/octave
2025-01-28 updated for +/-12v & 5v supply
2025-01-29 Added mux schematics
2025-01-30 Fixed +12v tuning issues
2025-01-30 Fixed portamento and param updates
    [16bit_1_note_Pico_MIDI_CV_poly_autotune.ino, Hardware.h, Parameters.h]
2025-01-30 Added PWM outputs from DAC
2025-01-30 Added PWM control over MIDI & Pots
2025-01-31 Tested PWM ranges and fixed accuracy of autotune
    [16bit_1_note_Pico_MIDI_CV_poly_autotune.ino]
2025-01-31 Fixed PWM range resistors
2025-01-31 Tested PWM range and fixed accuracy of tune
    [Hardware.h, Parameters.h]
2025-01-31 tested PWM
2025-02-01 Fixed volt/oct input
2025-02-01 Added CV on/off switch
2025-02-01 Added switch for CV off/on
2025-03-05 Fixed SPI wiring
