craigyjp/Pico-RP2040-Autotune-AS3340/(notices)

Notices in the files:
16bit_1_note_Pico_MIDI_CV_poly_autotune.ino:
This program is free software: you can redistribute it and/or modify
it under the terms of the GNU General Public License as published by
the Free Software Foundation, either version 3 of the License, or
(at your option) any later version.
